phil-barrett/Light-Sensor-Project/README.md

# Light-Sensor-Project

This project is to create a light sensor module that senses and reports UV, Visible ad IR wavelengths using AS7xxx sensors.

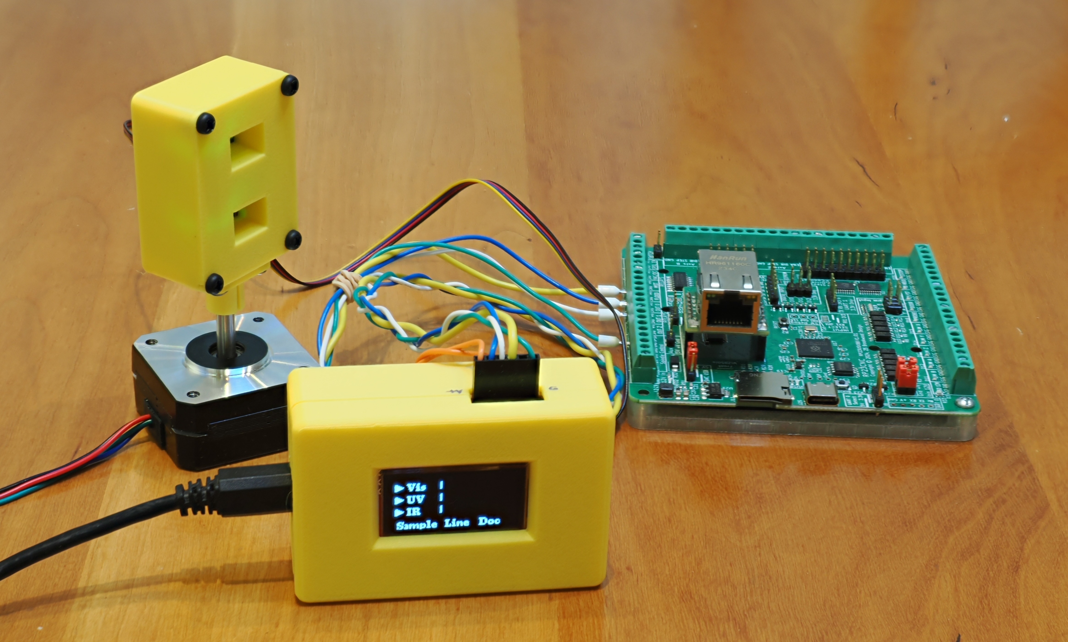
[picture p1: Images/T4261183.JPG]
Light Scanner
