phil-barrett/Light-Sensor-Project/3D Models/sensor scan head-sensor stepper mount.3mf

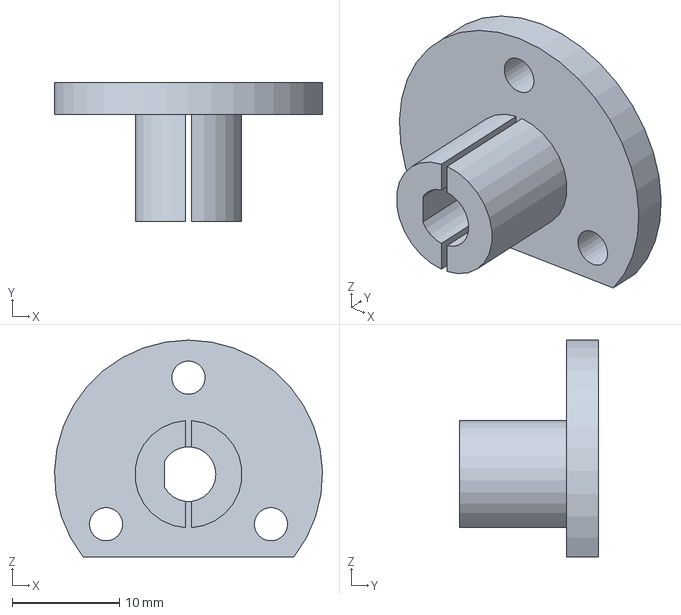
[picture p5: CAD file, 2026-04-16]
3D Models/sensor scan head-sensor stepper mount.3mf
25.0 x 13.0 x 20.2 mm
