phil-barrett/Light-Sensor-Project/3D Models/sensor scan head-sensor case.3mf

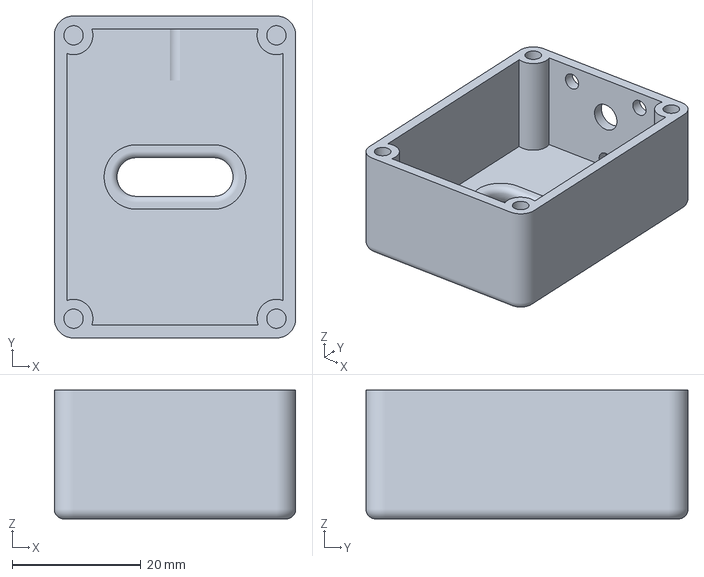
[picture p6: CAD file, 2026-04-16]
3D Models/sensor scan head-sensor case.3mf
37.5 x 50.0 x 20.0 mm
