phil-barrett/Light-Sensor-Project/3D Models/sensor scan head-sensor mount.3mf

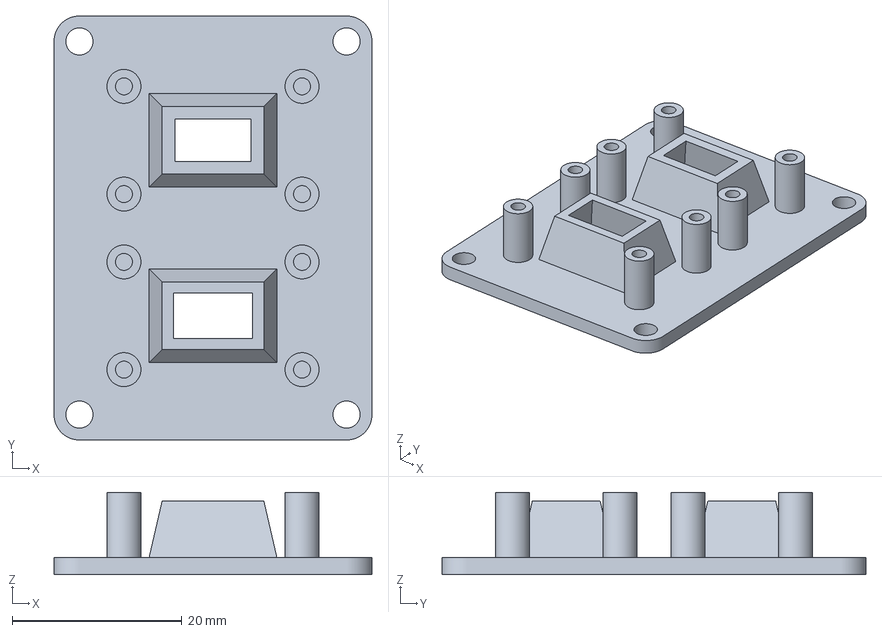
[picture p7: CAD file, 2026-04-16]
3D Models/sensor scan head-sensor mount.3mf
37.5 x 50.0 x 9.67 mm
