phil-barrett/Light-Sensor-Project/3D Models/Lightscanner case rear.3mf

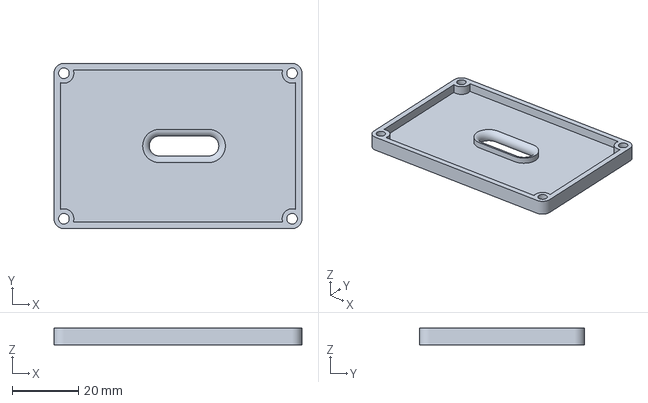
[picture p8: CAD file, 2026-04-15]
3D Models/Lightscanner case rear.3mf
75.0 x 50.0 x 5.00 mm
