phil-barrett/Light-Sensor-Project/3D Models/Lightscanner case middle.3mf

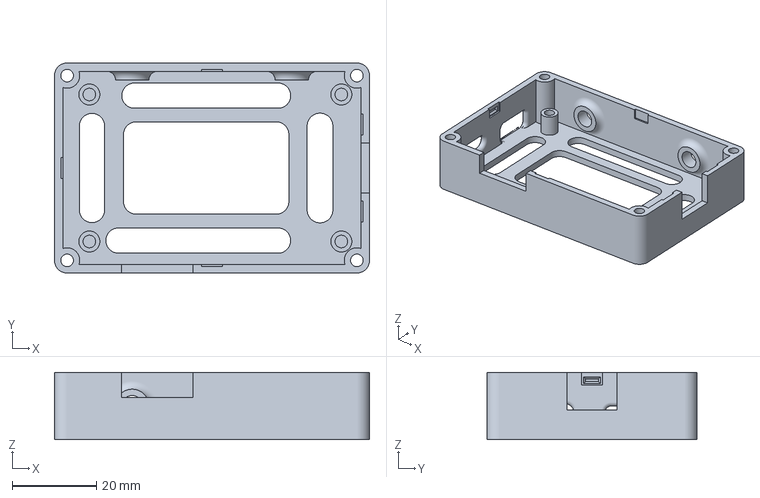
[picture p9: CAD file, 2026-04-15]
3D Models/Lightscanner case middle.3mf
75.0 x 50.0 x 16.0 mm
