phil-barrett/Light-Sensor-Project/3D Models/Lightscanner case front.3mf

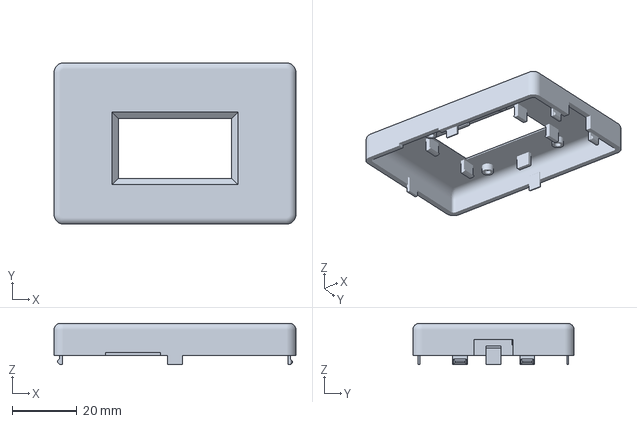
[picture p10: CAD file, 2026-04-15]
3D Models/Lightscanner case front.3mf
75.0 x 50.0 x 12.8 mm
