phil-barrett/Light-Sensor-Project/(commit log)

2026-04-09 Add files via upload
    small fix to all USB charging PSU (vs computer)
2026-04-09 Enhance Lightscanner notes with display and sensor info
    Added detailed notes on LCD display requirements, sensor support, COM port monitoring, and command usage for the light scanner.
2026-04-10 Update Lightscanner notes with version and commands
    Added Trigger Mode discussion, current version and improved command descriptions.
2026-04-10 Document connection methods for PicoBooster
    Added instructions for using screw terminals and pin headers with the RP23U5XBB.
2026-04-11 Enhance Light scanner documentation
    Updated notes for Light scanner with additional details on display requirements, graphics controller options, sensor data display, and command usage.
2026-04-11 Update current version to 0.72
2026-04-13 Revise Lightscanner notes with updates and clarifications
    Updated software version and expanded supported hardware section. Improved wiring instructions and clarified GCode sender requirements.
2026-04-15 Add files via upload
    fixed wiring error
2026-04-15 Enhance GCode instructions with Z-axis and Aux details
    Updated GCode commands to include Z-axis rotation and clarified comments regarding Aux triggers.
2026-04-15 Enhance wiring section with additional details
    Added information about purchasing QWIIC cables and recommended wire type with ferrules for the motion controller.
2026-04-16 Add README for 3D model assemblies
    Added notes and images for 3D model assemblies including the Sensor Scan head and Light Scanner Case.
2026-04-18 Enhance README with product links and updated images
    Added links to related products and updated images for the Light Scanner Case and Sensor Scan Head
2026-04-26 Update README with image of light sensor project
    Add image to README for visual reference
